sedorrr/c64-visualizer/docs/new_modes_preview.png

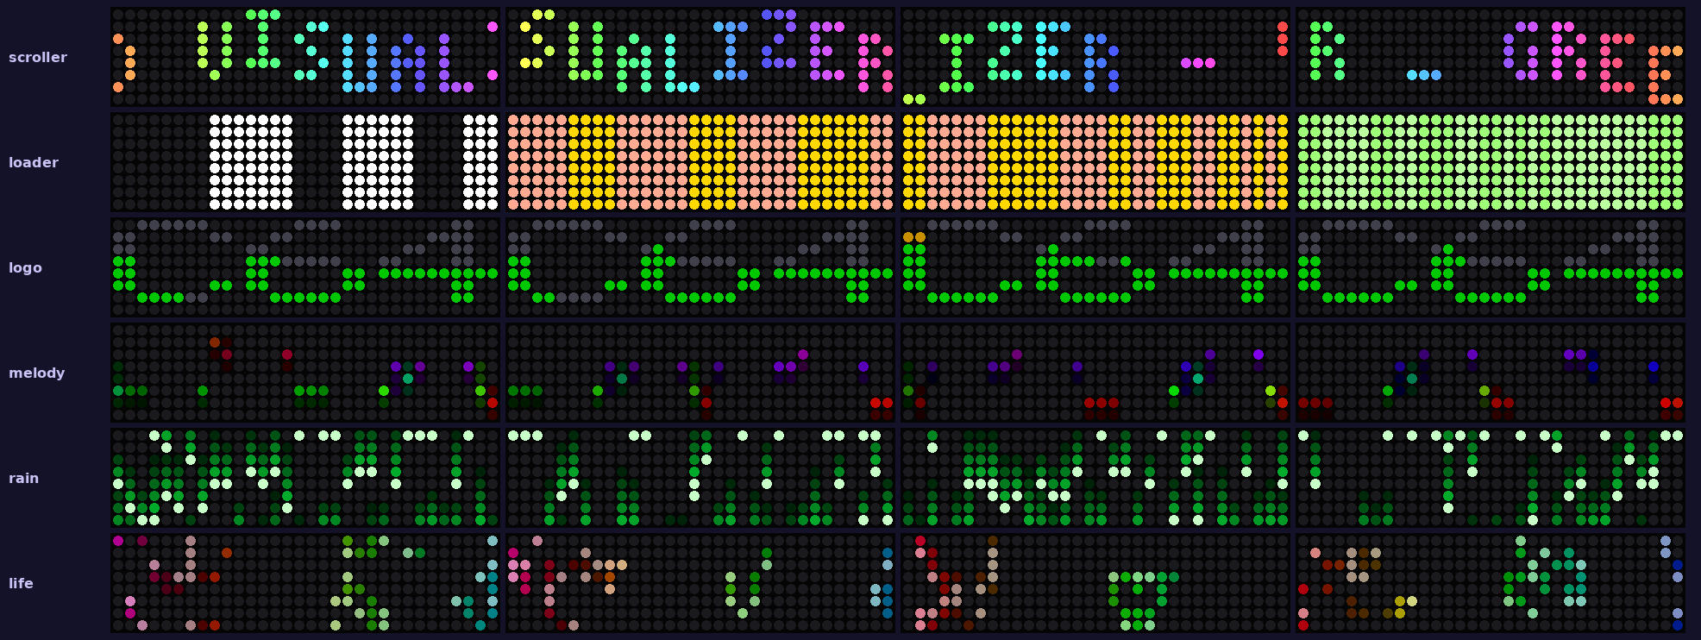
docs/new_modes_preview.png
