sedorrr/c64-visualizer/docs/schematic_minimal_de.png

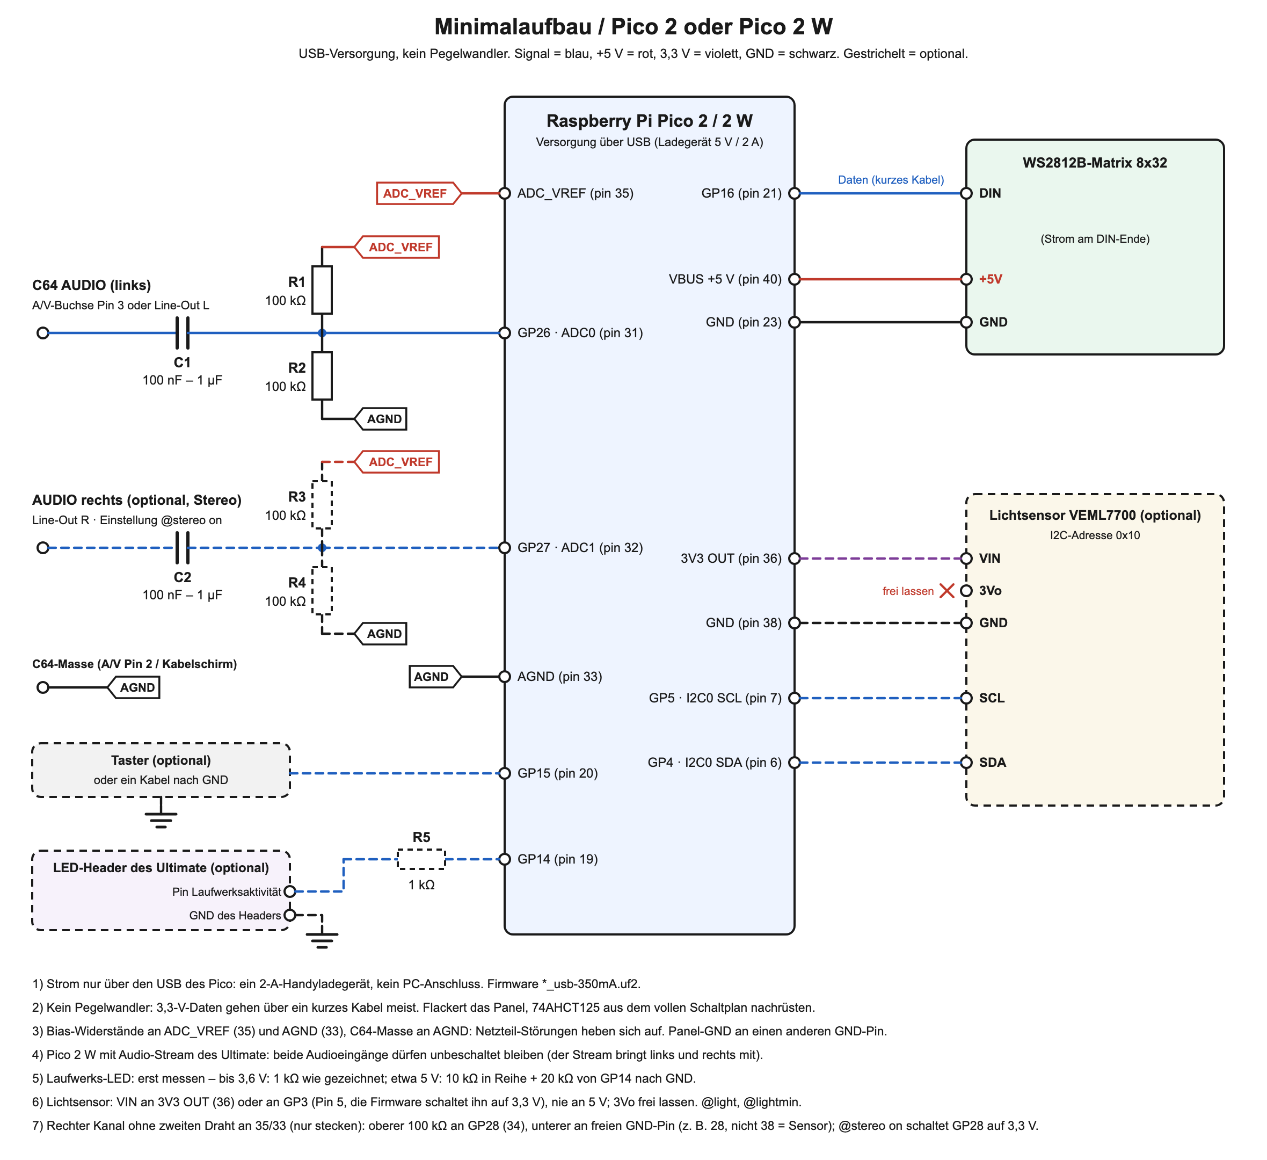
docs/schematic_minimal_de.png
