sedorrr/c64-visualizer/case/step/assembly_sensor_case.step

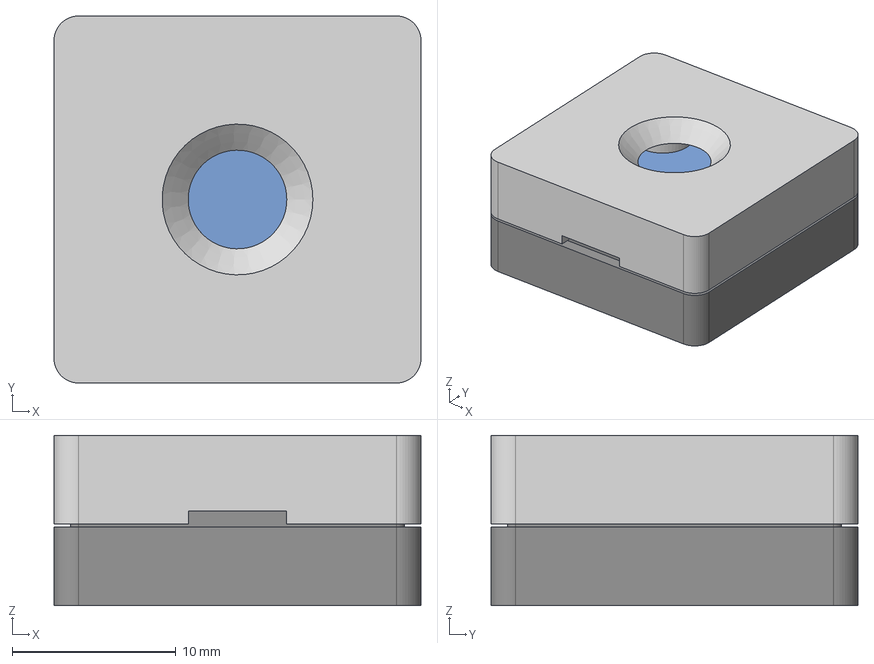
[picture p29: CAD file, 2026-10-26]
case/step/assembly_sensor_case.step
22.4 x 22.4 x 10.4 mm
sensor_base
sensor_lid
veml7700_board_reference
