sedorrr/c64-visualizer/case/step/assembly_case_with_clamps.step

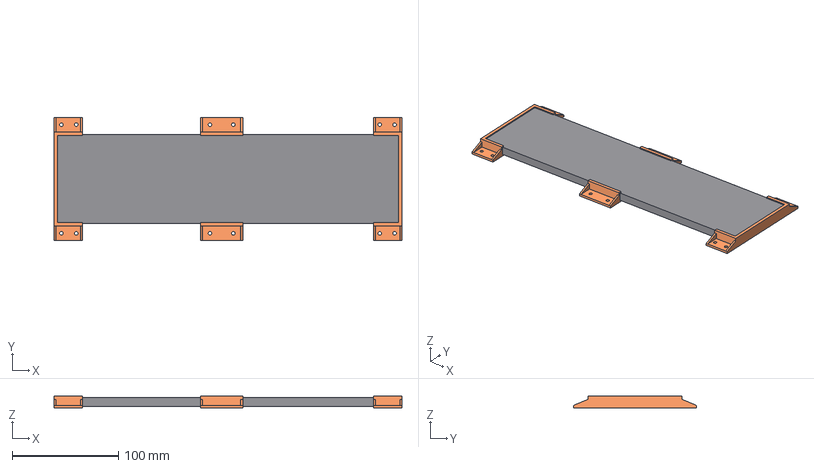
[picture p30: CAD file, 2026-10-26]
case/step/assembly_case_with_clamps.step
328.0 x 116.4 x 11.4 mm
case_reference_simplified
clamp_wings
endcap_left
endcap_right
