sedorrr/c64-visualizer/case/step/assembly_pico_case_with_clip.step

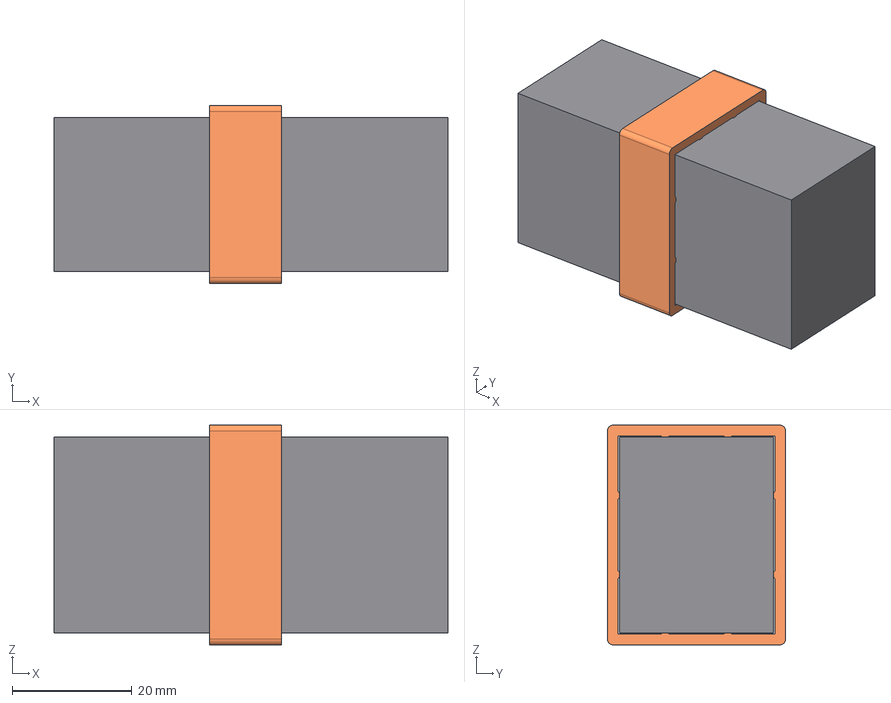
[picture p31: CAD file, 2026-10-26]
case/step/assembly_pico_case_with_clip.step
65.8 x 29.8 x 36.7 mm
pico_case_reference_simplified
pico_clip
