sedorrr/c64-visualizer/case/step/assembly_case_with_sensor_clamp.step

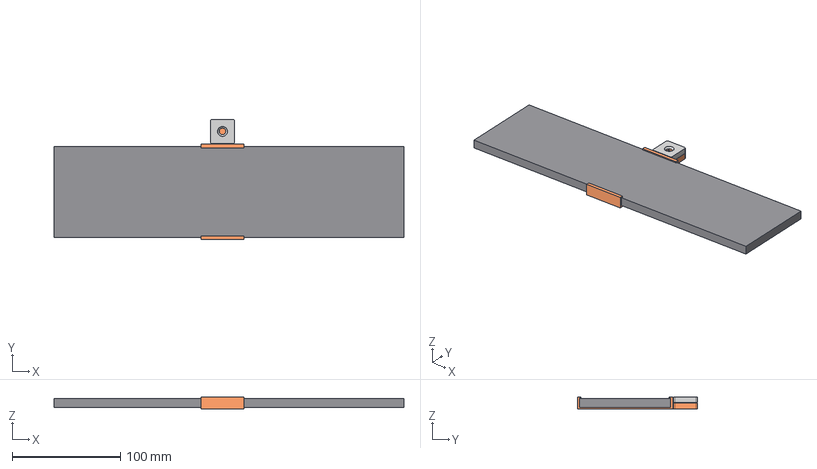
[picture p32: CAD file, 2026-10-26]
case/step/assembly_case_with_sensor_clamp.step
324.0 x 111.4 x 11.4 mm
case_reference_simplified
clamp_sensor
sensor_lid
