sedorrr/c64-visualizer/case/step/monitor_knob.step

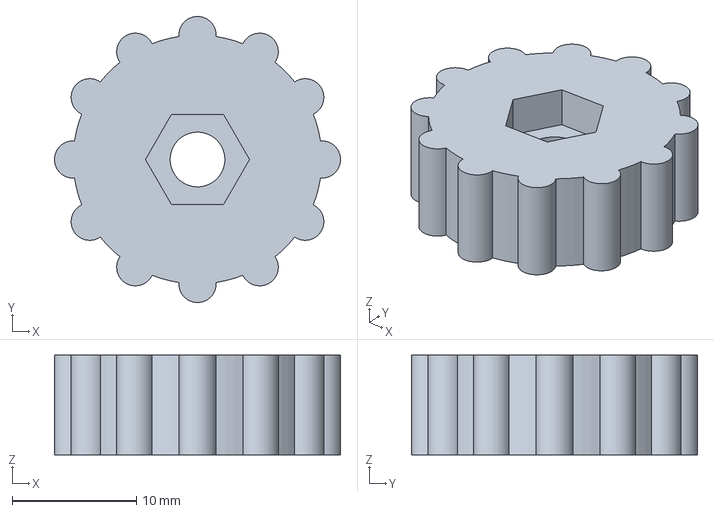
[picture p33: CAD file, 2026-10-26]
case/step/monitor_knob.step
23.0 x 23.0 x 8.00 mm
