sedorrr/c64-visualizer/case/tray.stl

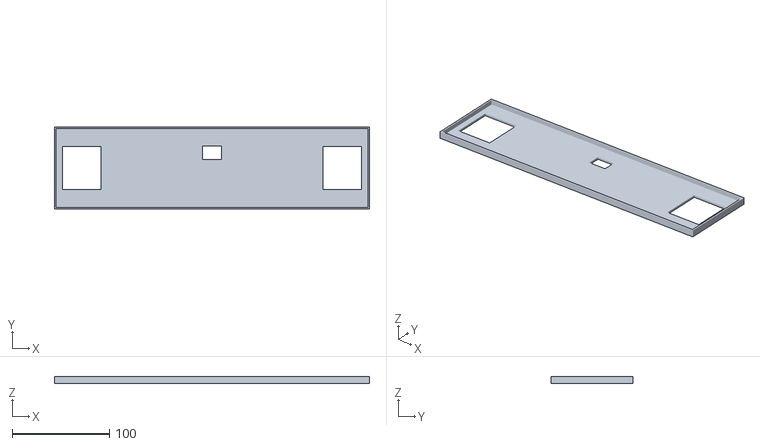
[picture p34: CAD file, 2026-10-26]
case/tray.stl
324.0 x 84.0 x 7.40
