sedorrr/c64-visualizer/case/pico_lid.stl

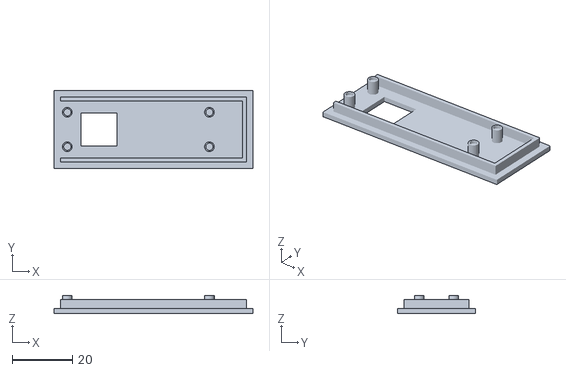
[picture p35: CAD file, 2026-10-26]
case/pico_lid.stl
65.8 x 25.8 x 6.00
