sedorrr/c64-visualizer/case/step/clamp.step

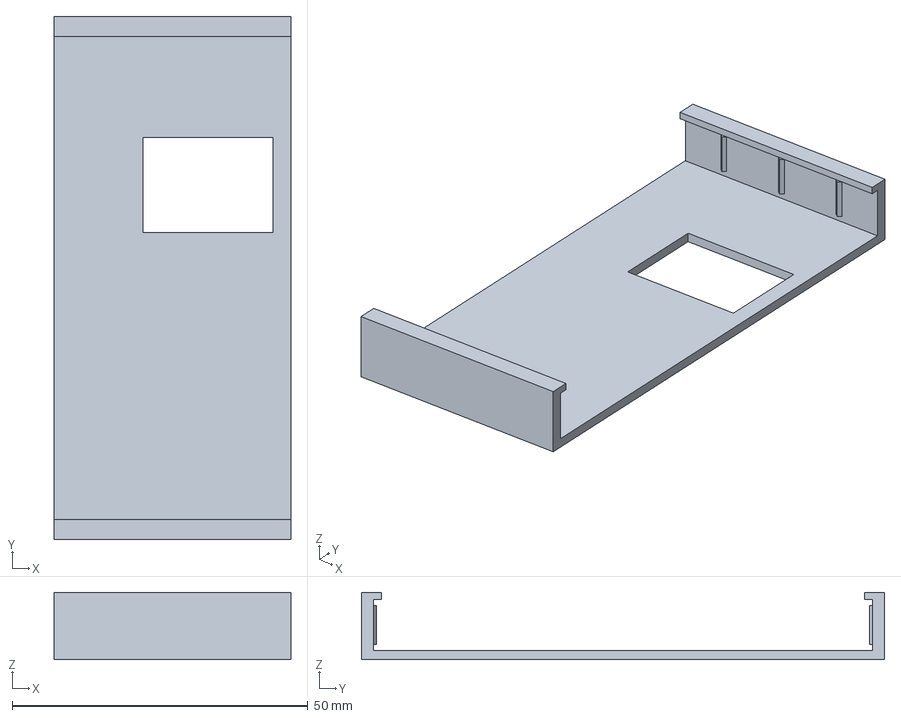
[picture p36: CAD file, 2026-10-26]
case/step/clamp.step
40.0 x 88.4 x 11.4 mm
