sedorrr/c64-visualizer/case/lid.stl

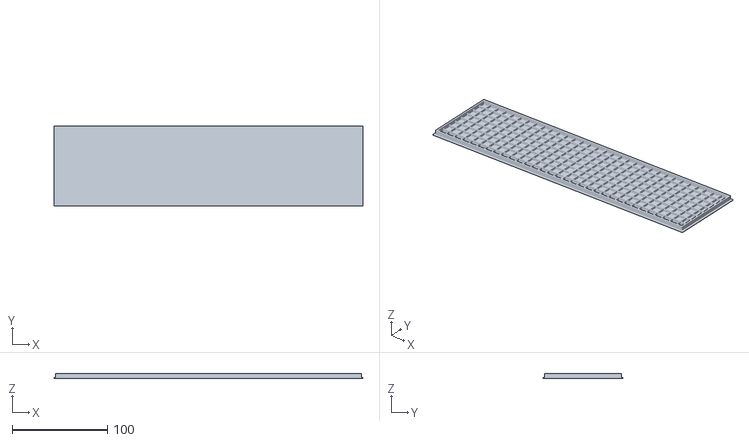
[picture p37: CAD file, 2026-10-26]
case/lid.stl
324.0 x 84.0 x 5.60
