sedorrr/c64-visualizer/case/step/pico_clip.step

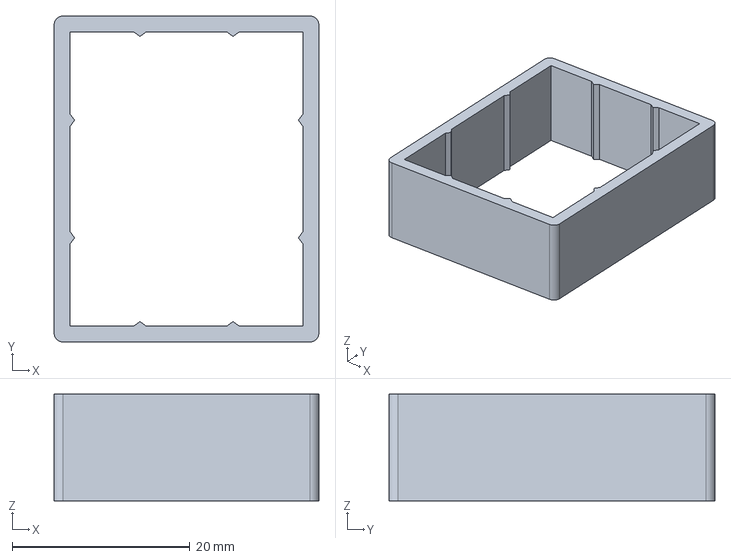
[picture p38: CAD file, 2026-10-26]
case/step/pico_clip.step
29.8 x 36.7 x 12.0 mm
