sedorrr/c64-visualizer/case/tray_left.stl

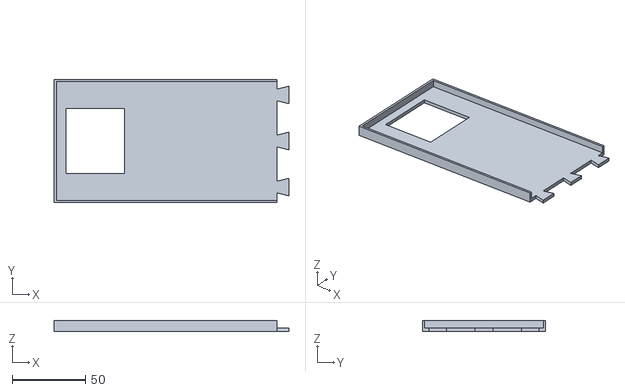
[picture p39: CAD file, 2026-10-26]
case/tray_left.stl
160.0 x 84.0 x 7.40
