sedorrr/c64-visualizer/case/pico_tray.stl

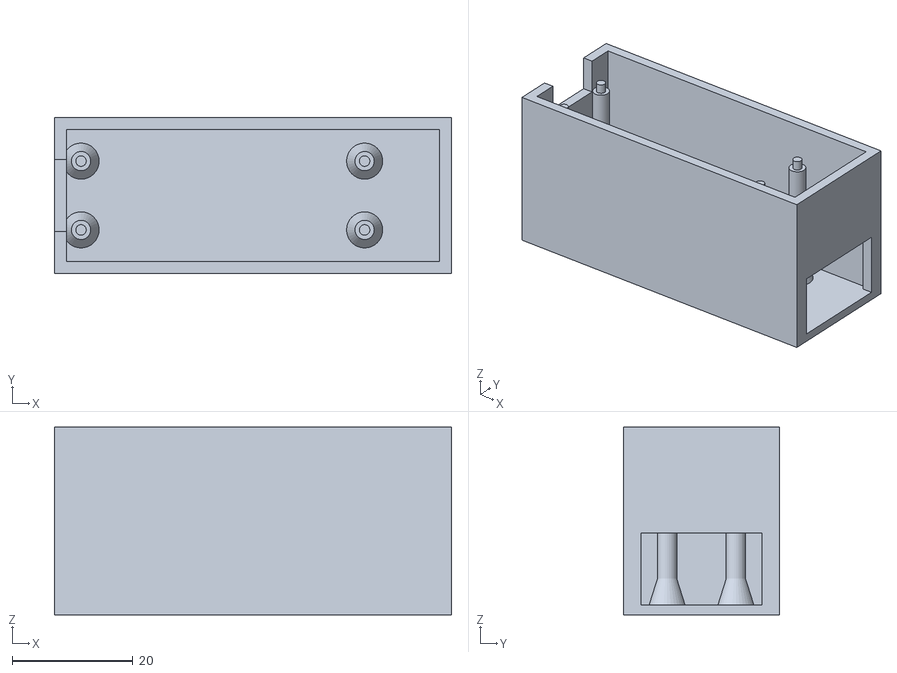
[picture p40: CAD file, 2026-10-26]
case/pico_tray.stl
65.8 x 25.8 x 31.1
