sedorrr/c64-visualizer/case/step/sensor_lid.step

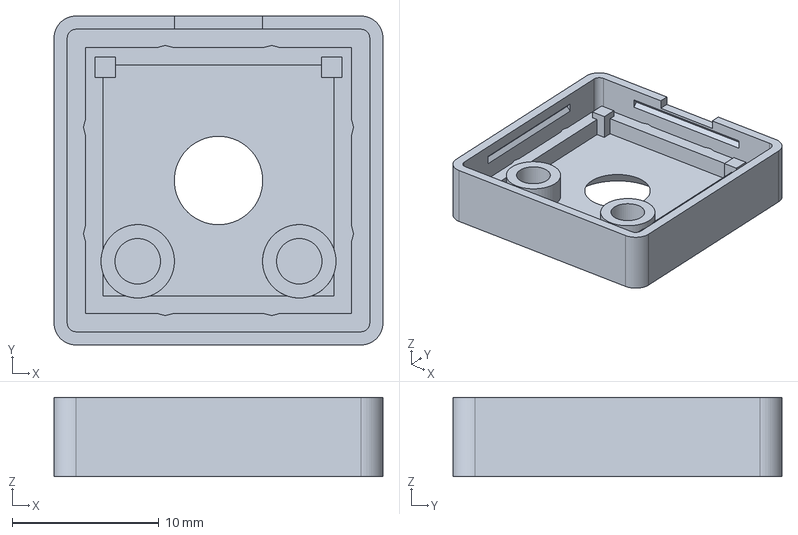
[picture p41: CAD file, 2026-10-26]
case/step/sensor_lid.step
22.4 x 22.4 x 5.40 mm
