sedorrr/c64-visualizer/case/step/clamp_sensor.step

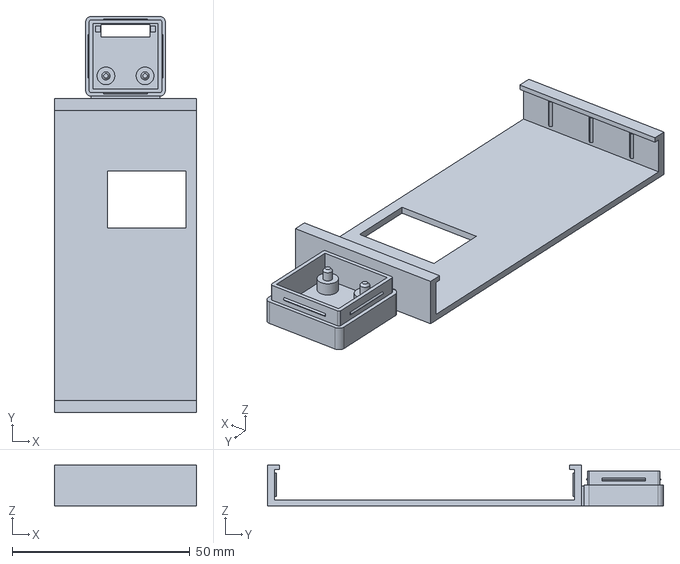
[picture p42: CAD file, 2026-10-26]
case/step/clamp_sensor.step
40.0 x 111.4 x 11.4 mm
