sedorrr/c64-visualizer/case/tray_right.stl

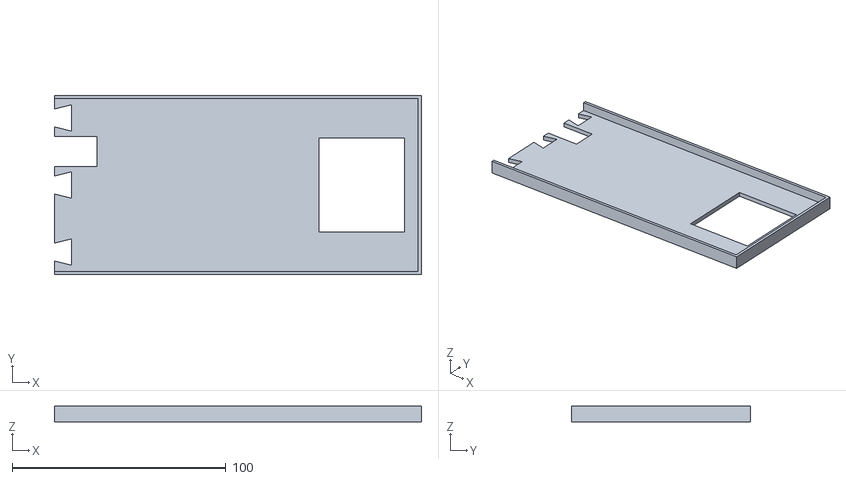
[picture p43: CAD file, 2026-10-26]
case/tray_right.stl
171.8 x 84.0 x 7.40
