sedorrr/c64-visualizer/case/lid_left.stl

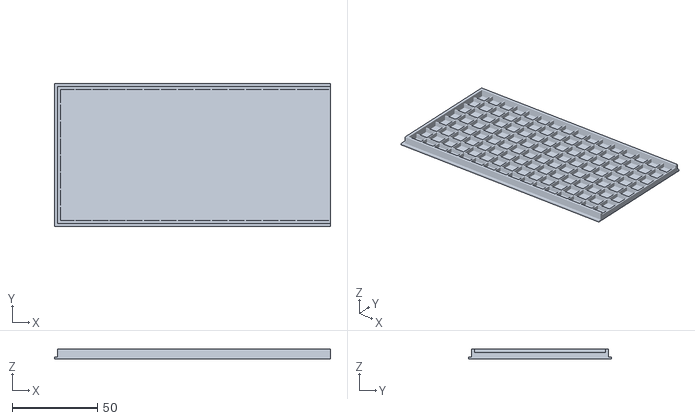
[picture p44: CAD file, 2026-10-26]
case/lid_left.stl
162.0 x 84.0 x 5.60
