sedorrr/c64-visualizer/case/step/endcap.step

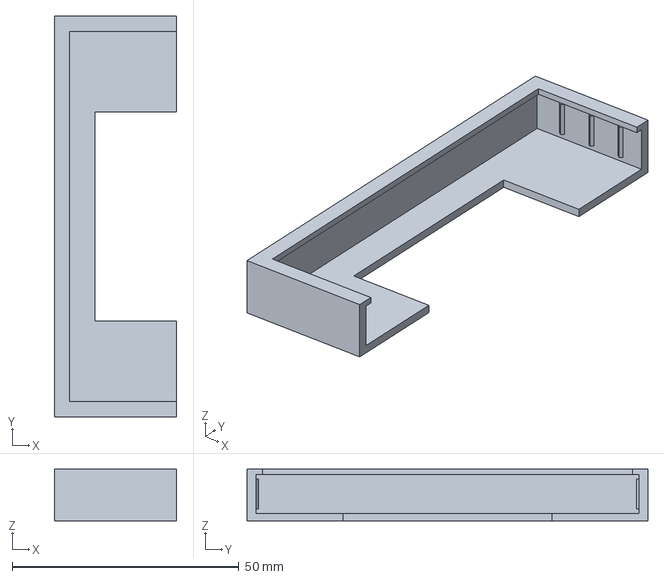
[picture p45: CAD file, 2026-10-26]
case/step/endcap.step
27.0 x 88.4 x 11.4 mm
