sedorrr/c64-visualizer/case/step/monitor_clip.step

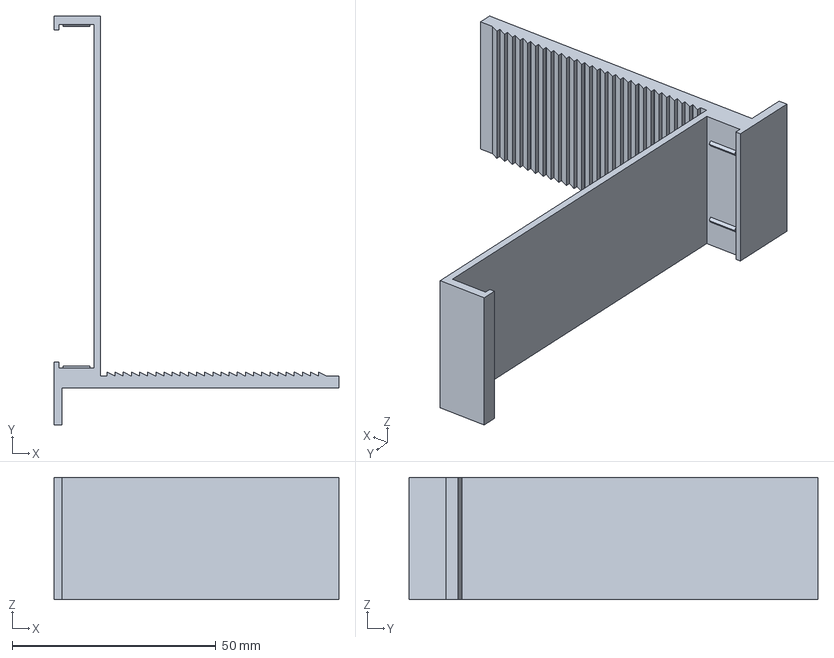
[picture p46: CAD file, 2026-10-26]
case/step/monitor_clip.step
70.0 x 100.4 x 30.0 mm
