sedorrr/c64-visualizer/case/step/monitor_pad.step

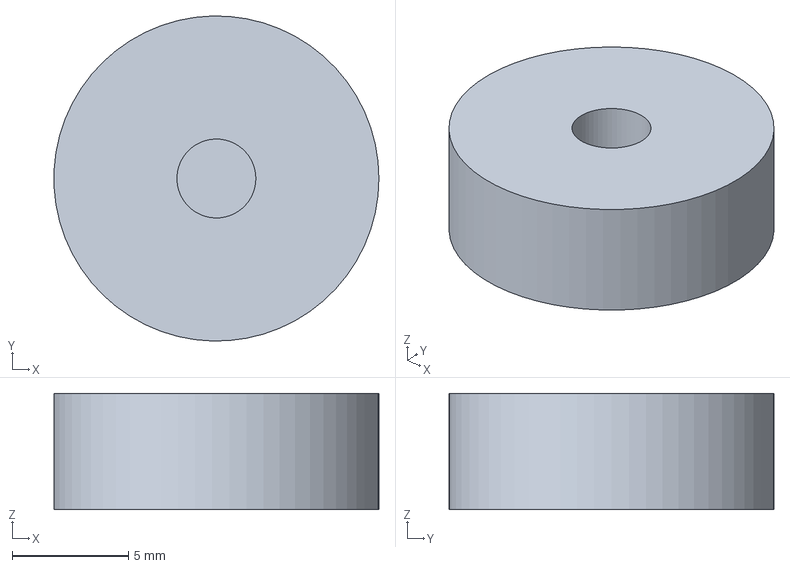
[picture p47: CAD file, 2026-10-26]
case/step/monitor_pad.step
14.0 x 14.0 x 5.00 mm
