sedorrr/c64-visualizer/case/step/endcap_wings.step

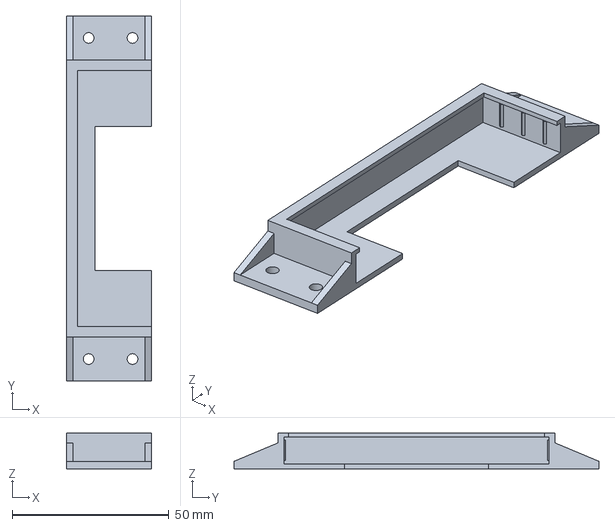
[picture p48: CAD file, 2026-10-26]
case/step/endcap_wings.step
27.0 x 116.4 x 11.4 mm
