sedorrr/c64-visualizer/case/step/clamp_wings.step

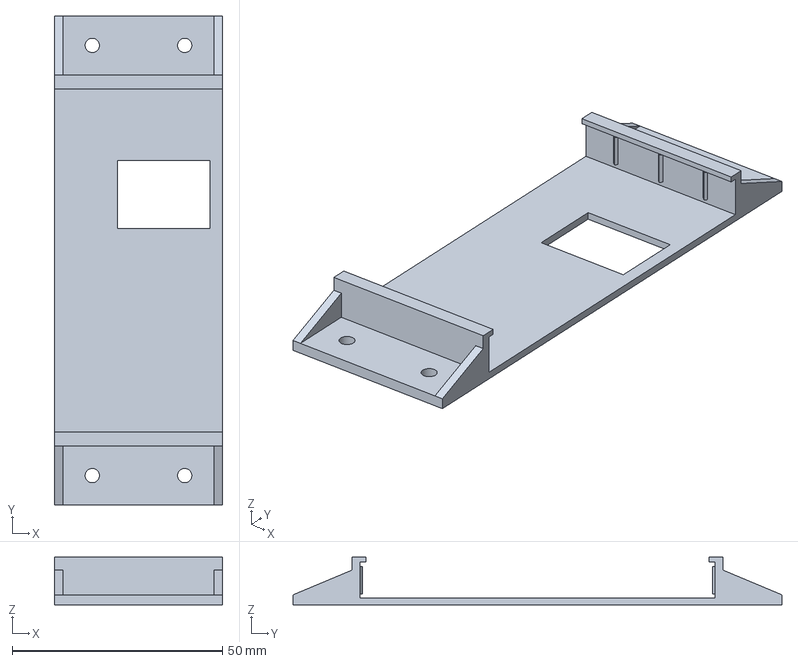
[picture p49: CAD file, 2026-10-26]
case/step/clamp_wings.step
40.0 x 116.4 x 11.4 mm
