sedorrr/c64-visualizer/case/step/monitor_mount.step

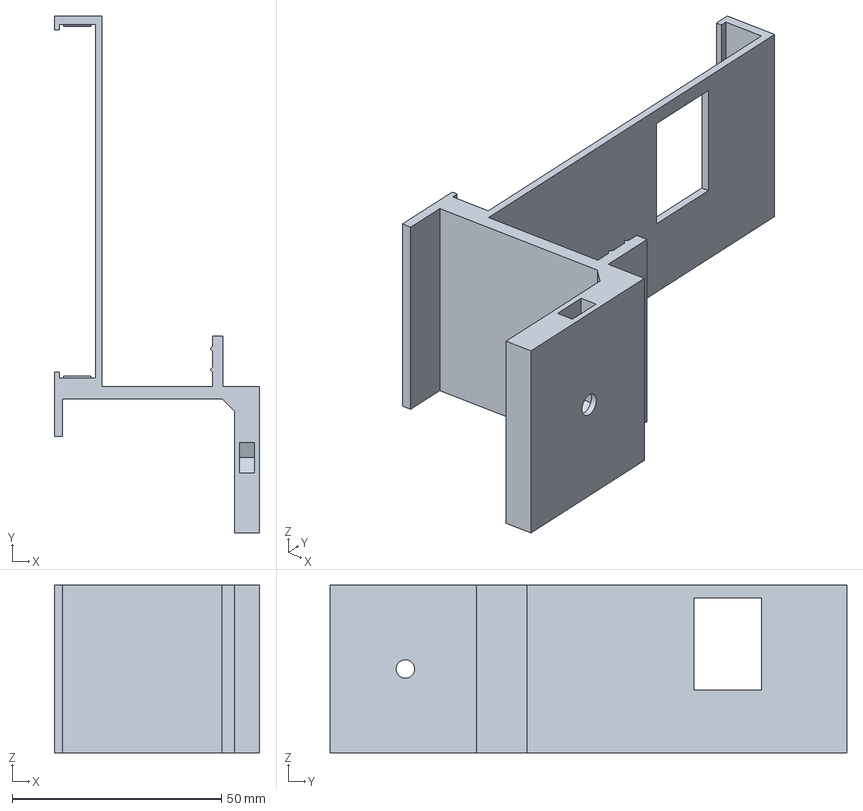
[picture p50: CAD file, 2026-10-26]
case/step/monitor_mount.step
49.0 x 123.4 x 40.0 mm
