sedorrr/c64-visualizer/case/step/monitor_jaw.step

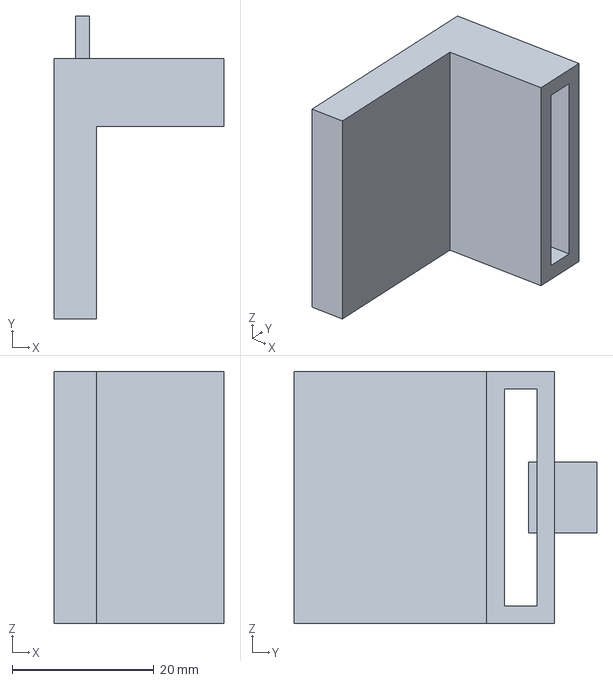
[picture p51: CAD file, 2026-10-26]
case/step/monitor_jaw.step
24.0 x 42.8 x 35.6 mm
