sedorrr/c64-visualizer/case/step/monitor_clip_pico.step

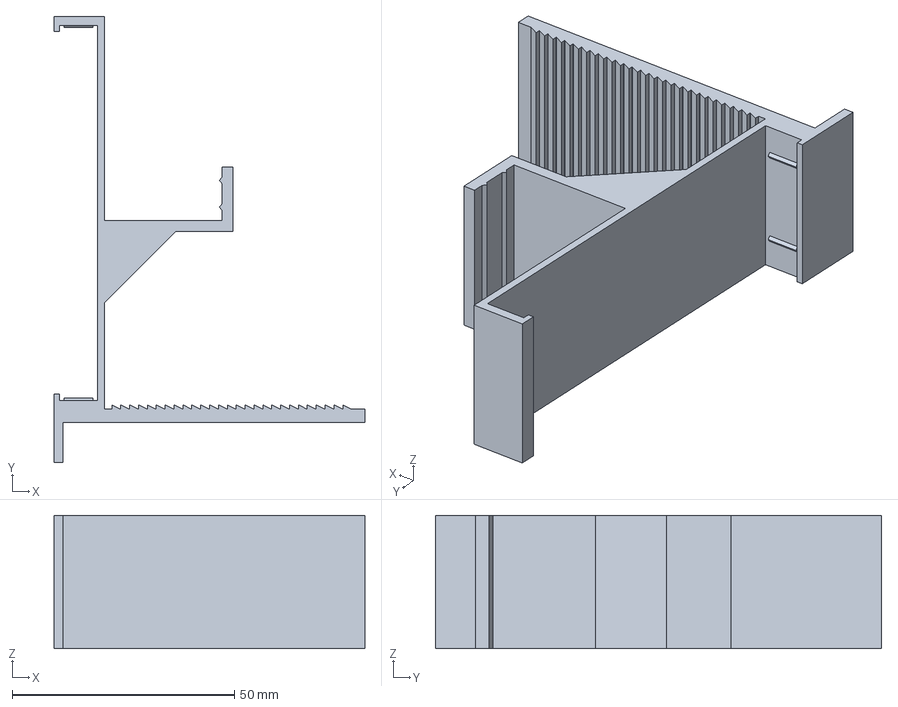
[picture p52: CAD file, 2026-10-26]
case/step/monitor_clip_pico.step
70.0 x 100.4 x 30.0 mm
