sedorrr/c64-visualizer/case/step/sensor_base.step

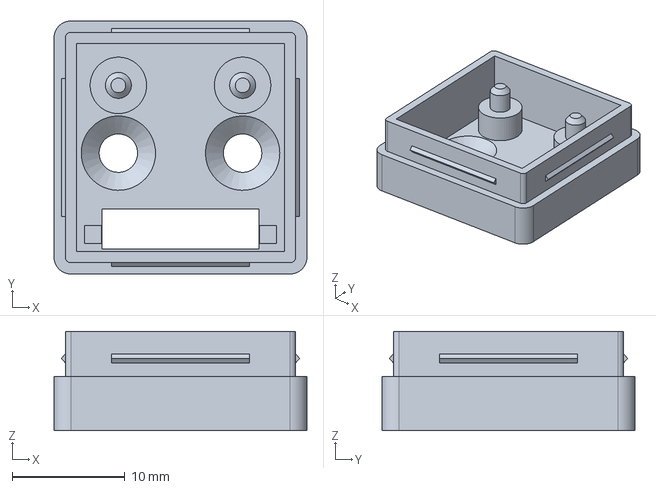
[picture p53: CAD file, 2026-10-26]
case/step/sensor_base.step
22.4 x 22.4 x 8.80 mm
