sedorrr/c64-visualizer/(list of files, cad)

Other CAD files:
case/step/clamp_sensor_other_side.step
case/lid_right.stl
case/clamp.stl
case/clamp_sensor.stl
case/clamp_sensor_other_side.stl
case/clamp_wings.stl
case/endcap.stl
case/endcap_wings.stl
case/monitor_clip.stl
case/monitor_clip_pico.stl
case/monitor_jaw.stl
case/monitor_knob.stl
case/monitor_mount.stl
case/monitor_pad.stl
case/pico_clip.stl
case/sensor_base.stl
case/sensor_lid.stl
